htj972/auto-fish-feeder/3mf导出/外壳.3mf

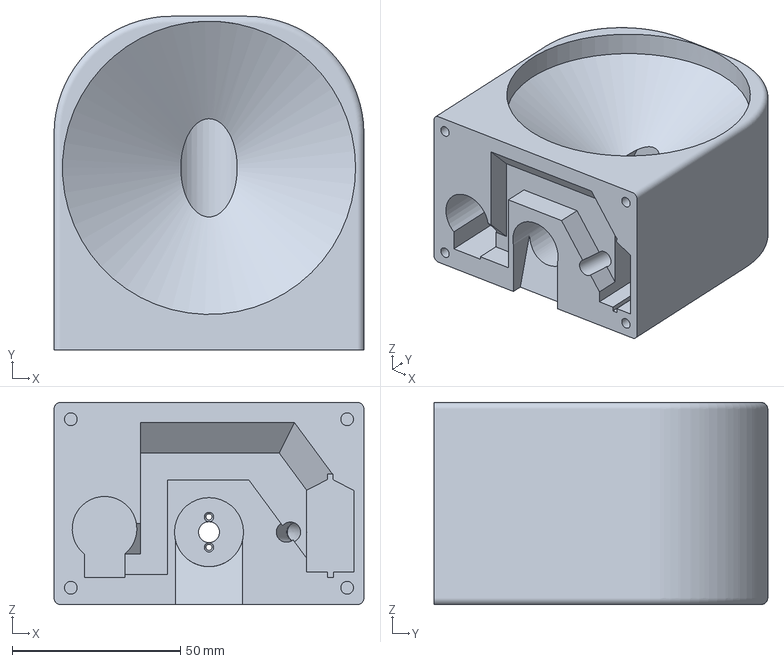
[picture p1: CAD file, 2026-10-22]
3mf导出/外壳.3mf
92.0 x 99.0 x 60.0 mm
