htj972/auto-fish-feeder/自动喂鱼器.STEP

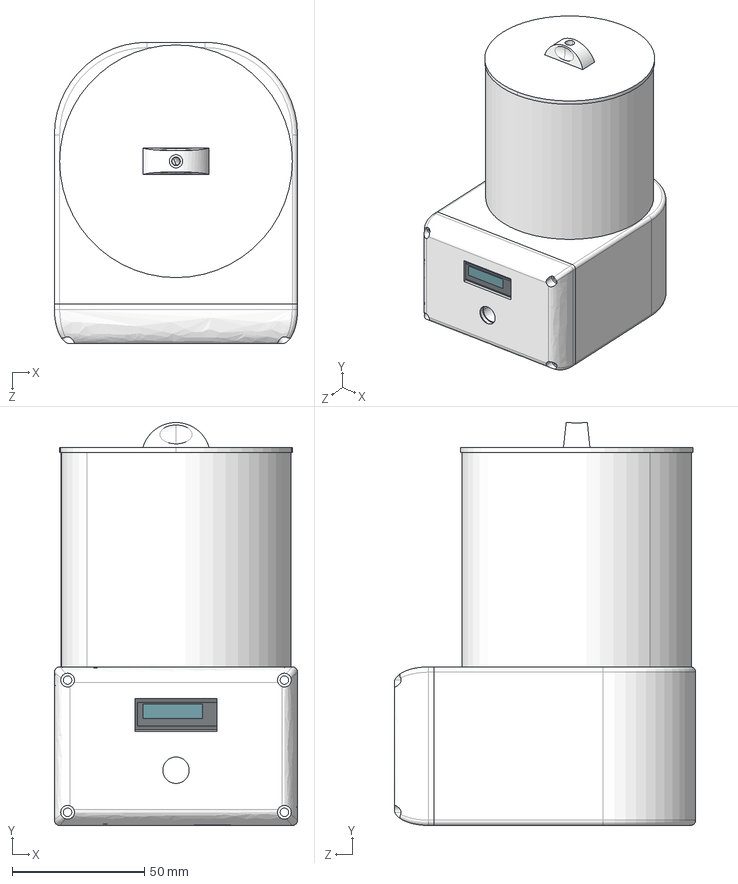
[picture p2: CAD file, 2026-10-20]
自动喂鱼器.STEP
92.0 x 152.4 x 114.0 mm
外壳
料盒
盖把手
料盒盖
螺旋
N20
面板
Board_38x12_unsoldered
OLED_glass_envelope_ASSUMED
Display_area_22p38x5p52
