htj972/auto-fish-feeder/3mf导出/按钮.3MF

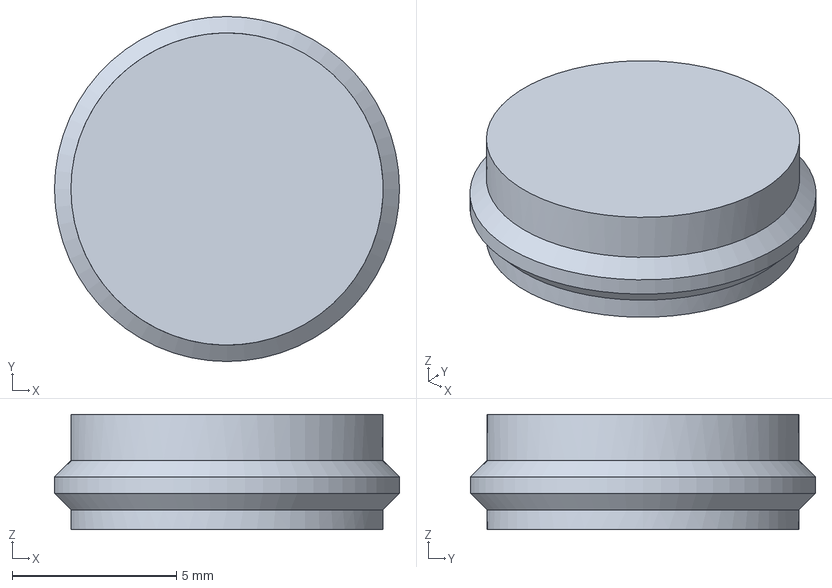
[picture p3: CAD file, 2026-10-21]
3mf导出/按钮.3MF
10.5 x 10.5 x 3.50 mm
