htj972/auto-fish-feeder/OLED_091_38x12_no_header.stp

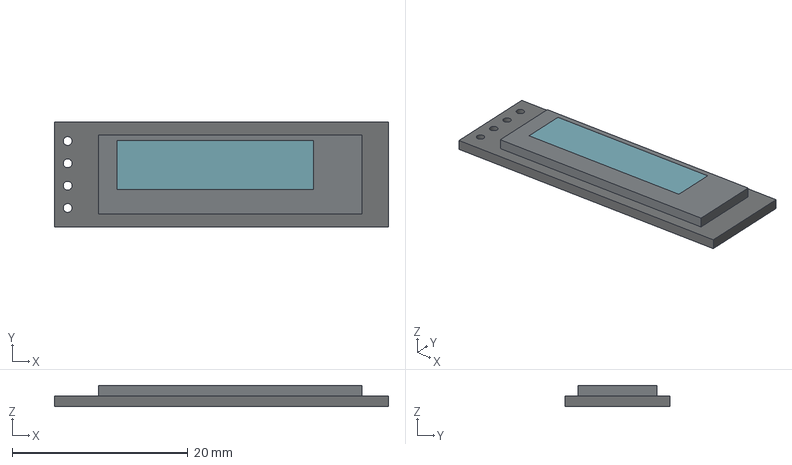
[picture p4: CAD file, 2026-10-20]
OLED_091_38x12_no_header.stp
38.0 x 12.0 x 2.40 mm
Board_38x12_unsoldered
OLED_glass_envelope_ASSUMED
Display_area_22p38x5p52
