htj972/auto-fish-feeder/3mf导出/料盒盖.3MF

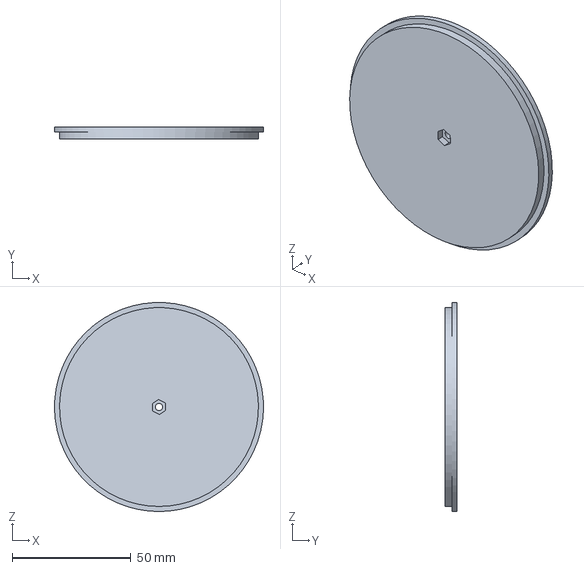
[picture p5: CAD file, 2026-10-20]
3mf导出/料盒盖.3MF
88.0 x 5.00 x 88.0 mm
