htj972/auto-fish-feeder/3mf导出/料盒.3MF

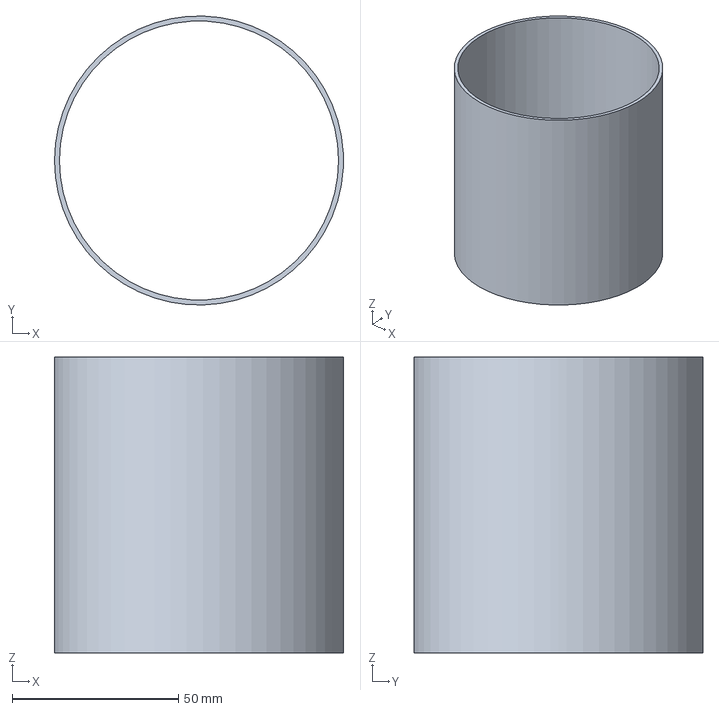
[picture p6: CAD file, 2026-10-20]
3mf导出/料盒.3MF
87.0 x 87.0 x 89.0 mm
