htj972/auto-fish-feeder/3mf导出/面板.3mf

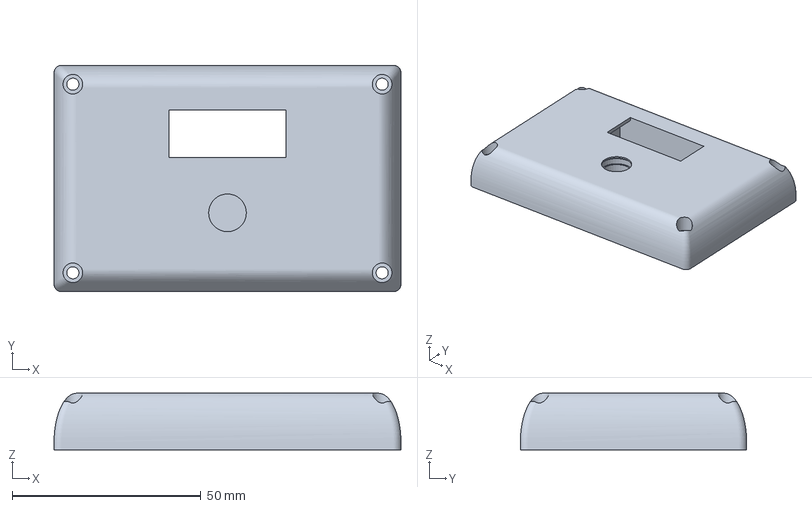
[picture p7: CAD file, 2026-10-20]
3mf导出/面板.3mf
92.0 x 60.0 x 15.0 mm
