htj972/auto-fish-feeder/3mf导出/螺旋.3MF

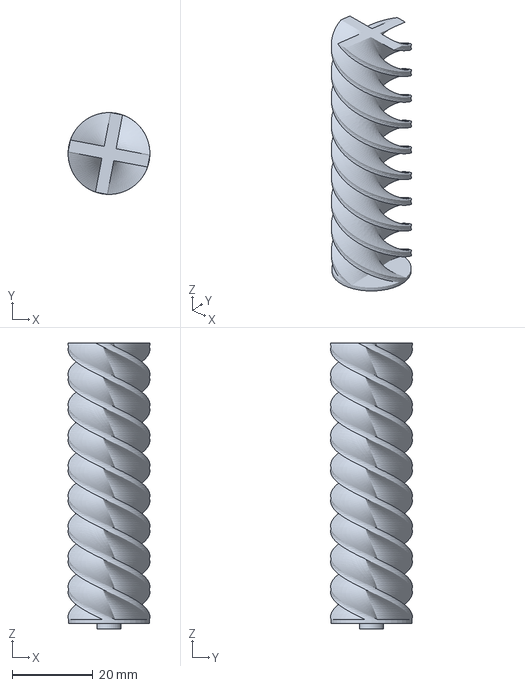
[picture p8: CAD file, 2026-10-20]
3mf导出/螺旋.3MF
20.2 x 20.2 x 70.7 mm
