htj972/auto-fish-feeder/3mf导出/盖把手.3MF

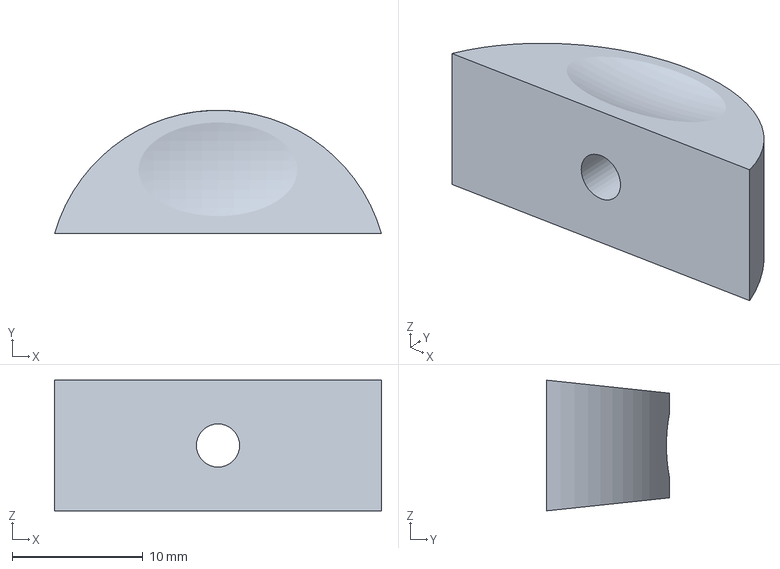
[picture p9: CAD file, 2026-10-20]
3mf导出/盖把手.3MF
25.0 x 9.43 x 10.0 mm
