htj972/auto-fish-feeder/(list of files, drawings)

Other design files:
PCB/feed.PcbDoc
PCB/feed.SchDoc
PCB/feedfish.PrjPcb
