htj972/auto-fish-feeder/esp32/include/button.h

#pragma once
#include <Arduino.h>
void beginButton();
void beginButtonTask();
void tickButtonActions();
bool takeButtonIpRequest();
bool takeButtonDisplayActivity();
void tickButton();
bool buttonIsArming();
bool buttonIsFeeding();
uint32_t buttonHoldElapsed();
