htj972/auto-fish-feeder/esp32/include/power_monitor.h

#pragma once
#include <Arduino.h>
void beginPower();
void tickPower();
const char *chargeText();
float batteryVoltage();
bool batteryIsOverrange();
int chargeLevel();
int chargeDoneLevel();
bool batteryIsPresent();
bool batteryIsCharging();
int batteryPercent();
